Neurotech-Hub/HeatPad-Controller/KiCAD/Heat_Pad_v1.0/Heat_Pad_v1.0.step

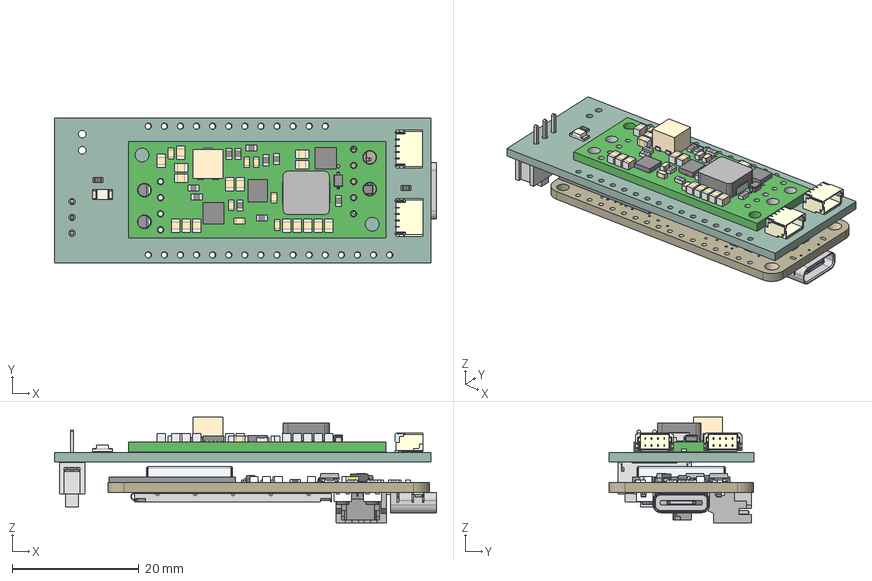
[picture p2: CAD file, 2026-10-29]
KiCAD/Heat_Pad_v1.0/Heat_Pad_v1.0.step
60.3 x 22.9 x 16.7 mm
I2C-Connector x 2
LED_1206_3216Metric
step-up-voltage-regulator-u3v70x
R_0603_1608Metric x 2
EG1218
Board
0805-NO x 8
SOT23-5 x 3
SOD-123
JSTPH2_BATT
CHIPLED_0603_NOOUTLINE x 2
0603-NO x 14
BTN_KMR2_4.6X2.8 x 2
SOT23-R x 2
USB_C_CUSB31-CFM2AX-01-X
WLCSP9
JST_SH4_RA
SK6805_1515
TFT_1.14IN_240X135_WRAPUNDER
RESPACK_4X0603
QFN60_ESP32-S2-MINI-1_EXP
Heat_Pad_v1.0_PCB
