Neurotech-Hub/HeatPad-Controller/KiCAD/Heat_Pad_v1.0/Heat_Pad_v1.0.kicad_pcb

## KiCad design KiCAD/Heat_Pad_v1.0/Heat_Pad_v1.0.kicad_pcb (2026-10-29)

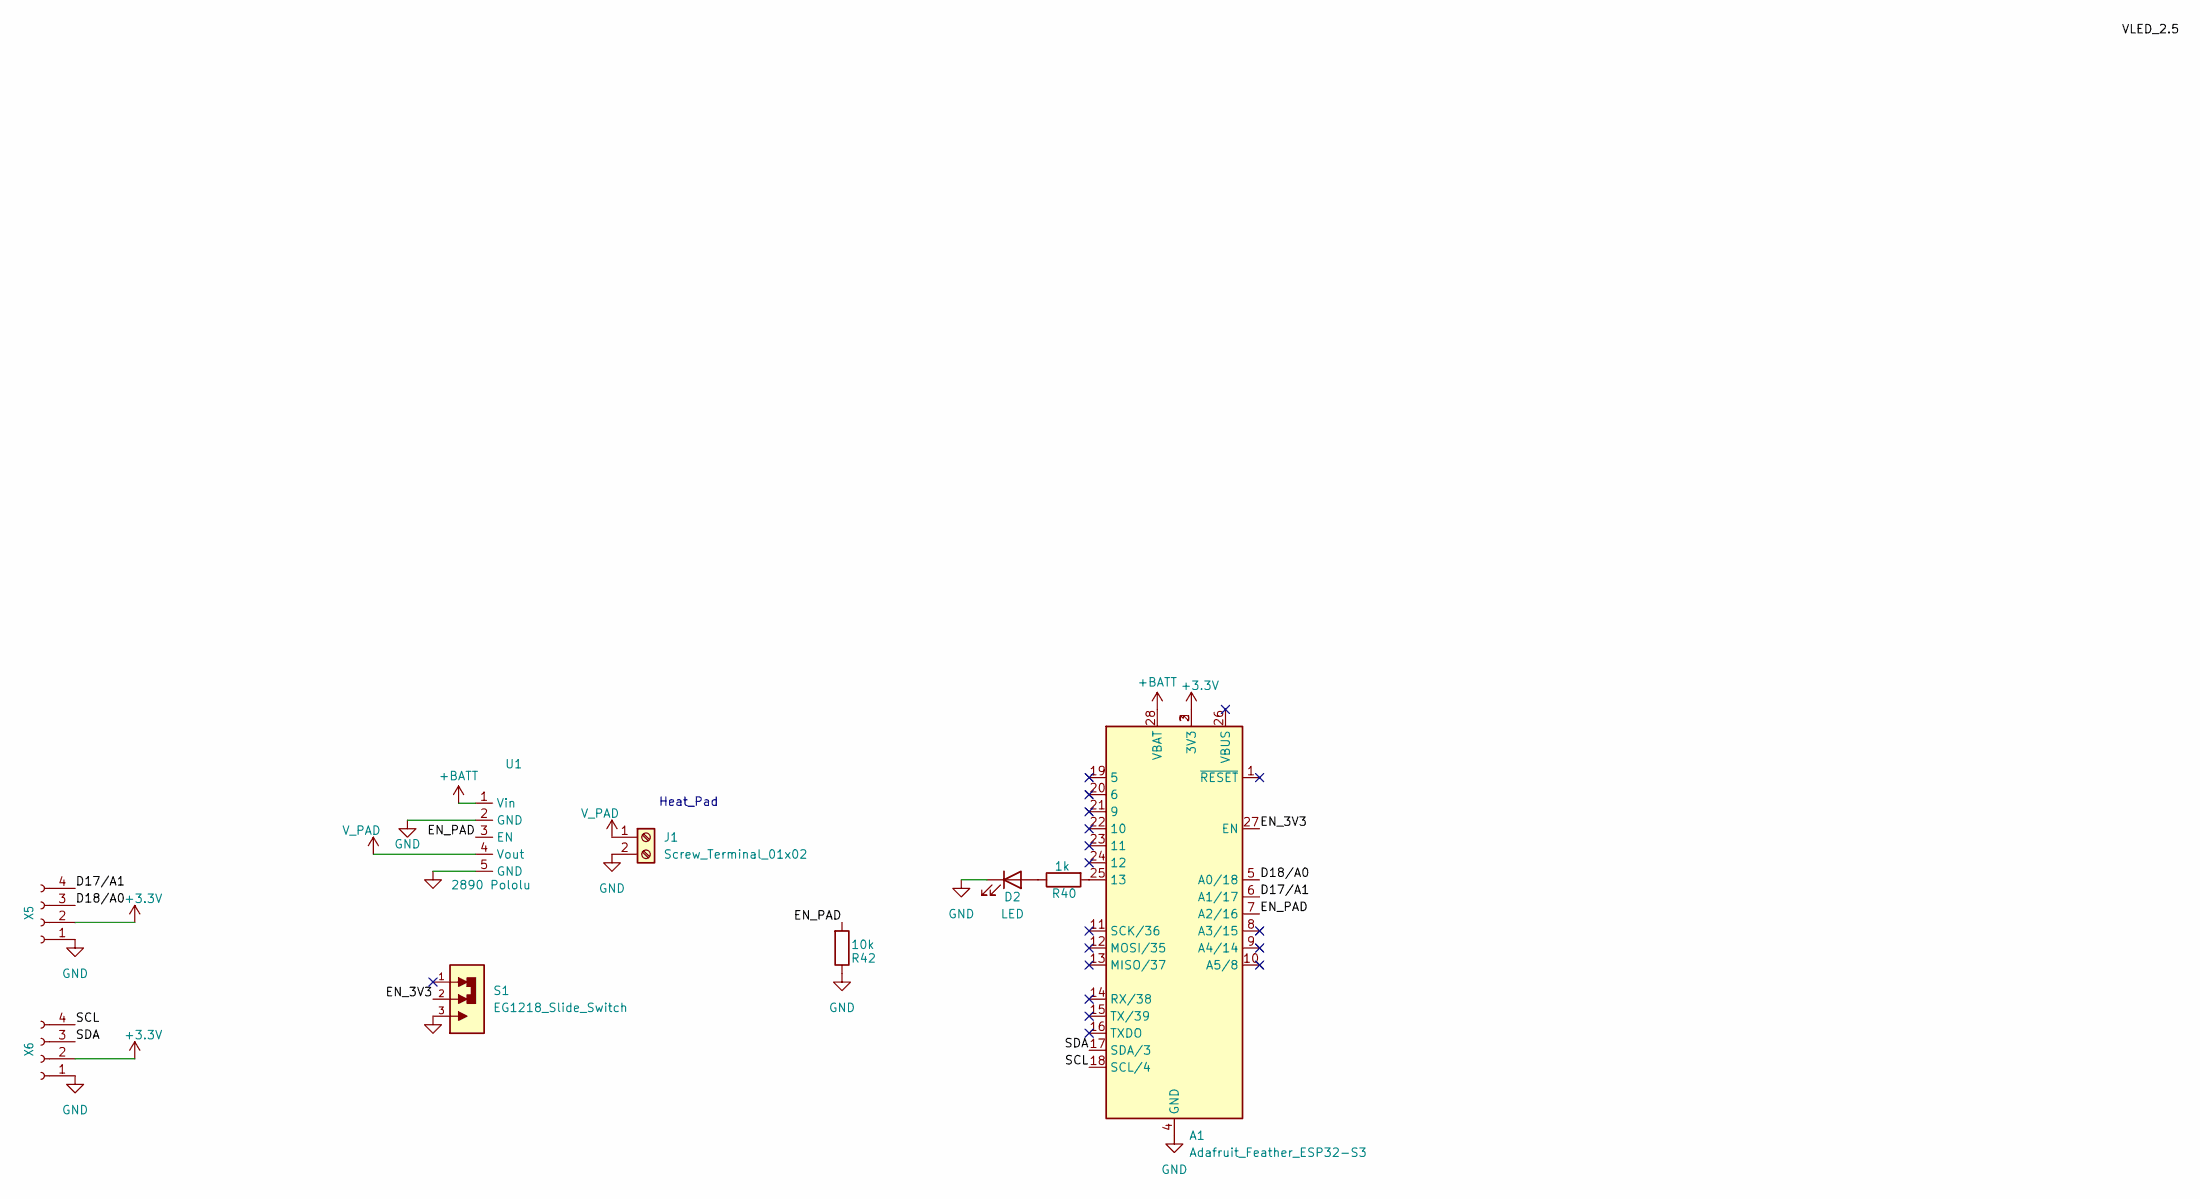
[picture p3: schematic Heat_Pad_v1.0.kicad_sch]

Parts:
A1: Adafruit_Feather_ESP32-S3; DigiKey 1528-5483-ND
D2: LED; LED_1206_3216Metric; DigiKey 160-1405-1-ND
J1: Screw_Terminal_01x02; TerminalBlock_Xinya_XY308-2.54-2P_1x02_P2.54mm_Horizontal
R40: 1k; R_0603_1608Metric; LCSC C21190
R42: 10k; R_0603_1608Metric; DigiKey 311-10.0KMCT-ND
S1: EG1218_Slide_Switch; SW_EG1218; DigiKey EG1903-ND
U1: 2890 Pololu; u3v70x_Pololu; DigiKey 2183-2890-ND
X5, X6: JSTPH; X5_JST_SH_SM04B-SRSS-TB_1x04-1MP_P1.00mm_Horizontal; LCSC C160404

Connections:
+3.3V: A1.2 (3V3), A1.3 (3V3), X5.2, X6.2
+12V: J1.1, U1.4 (Vout)
+BATT: A1.28 (VBAT), U1.1 (Vin)
/D9: A1.21 (9)
/D17/A1: A1.6 (A1/17), X5.4
/D18/A0: A1.5 (A0/18), X5.3
/EN_3V3: A1.27 (EN), S1.2
/EN_12V: A1.7 (A2/16), R42.2, U1.3 (EN)
/SCL: A1.18 (SCL/4), X6.4
/SDA: A1.17 (SDA/3), X6.3
GND: A1.4 (GND), D2.1 (K), J1.2, R42.1, S1.3, U1.2 (GND), U1.5 (GND), X5.1, X6.1
unnamed: A1.25 (13), R40.2
unnamed: D2.2 (A), R40.1

Notes on the sheet:
Heat_Pad

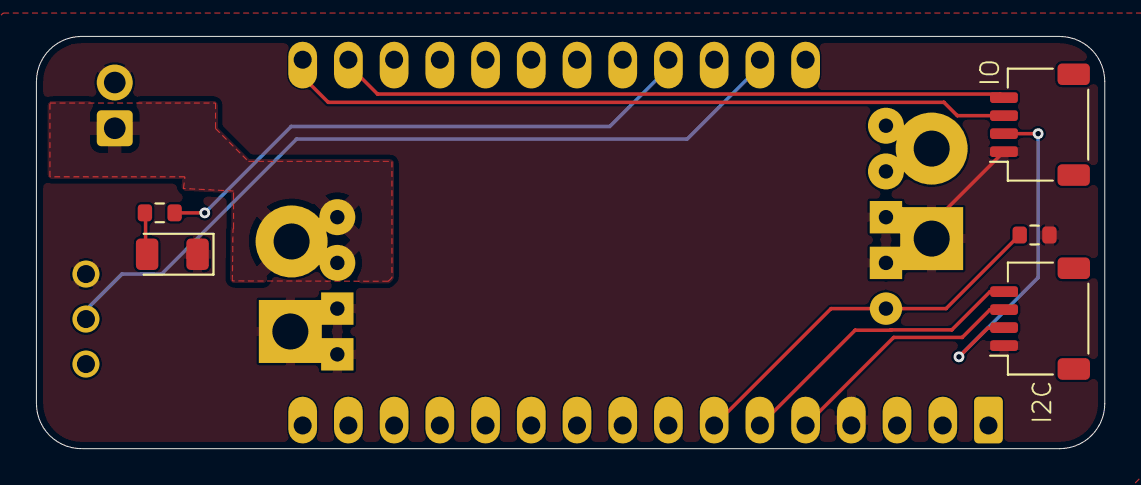
[picture p4: board Heat_Pad_v1.0.kicad_pcb from above]

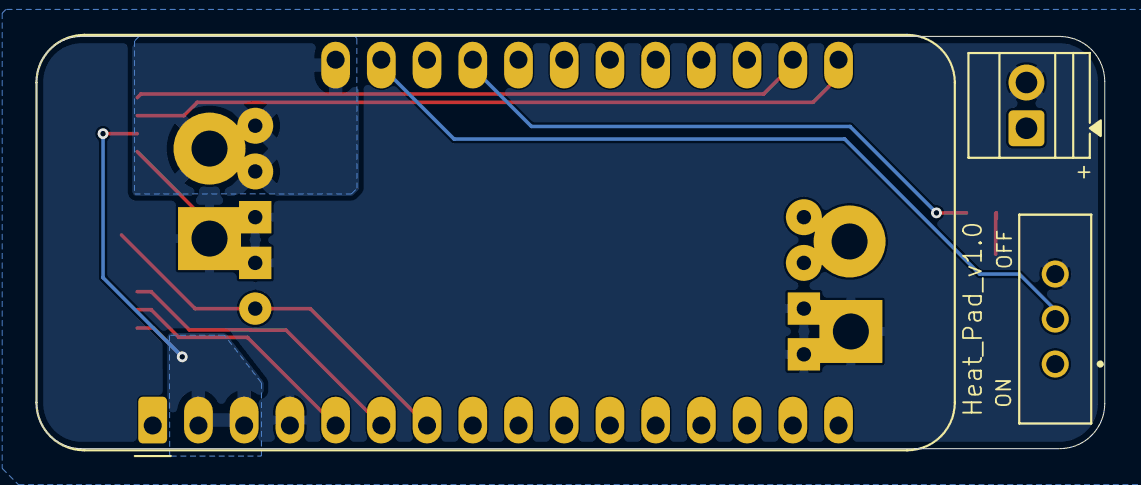
[picture p5: board Heat_Pad_v1.0.kicad_pcb from below]

Board: 2 copper layers, 59.3 x 22.9 mm, 9 parts (3 on the bottom side), 12 nets.
