Neurotech-Hub/HeatPad-Controller/(commit log)

2026-10-29 documentation and file arrangements
    [Heat_Pad_v1.0.kicad_pcb, Heat_Pad_v1.0.kicad_sch, Heat_Pad_v1.0.step]
2026-10-29 Change project title to 'Heat Pad Controller'
    Updated project title and clarified description.
